ElijahSargeant/DelSlowEGT/(list of files, cad)

Other CAD files:
PCB/DelSlowEGT/ADC.dwg
PCB/DelSlowEGT/BAT.dwg
PCB/DelSlowEGT/3.3V.dwg
PCB/DelSlowEGT/MCUPinout.dwg
PCB/DelSlowEGT/ETH.dwg
