ElijahSargeant/DelSlowEGT/PCB/DelSlowEGT/DelSlowEGT.pdf

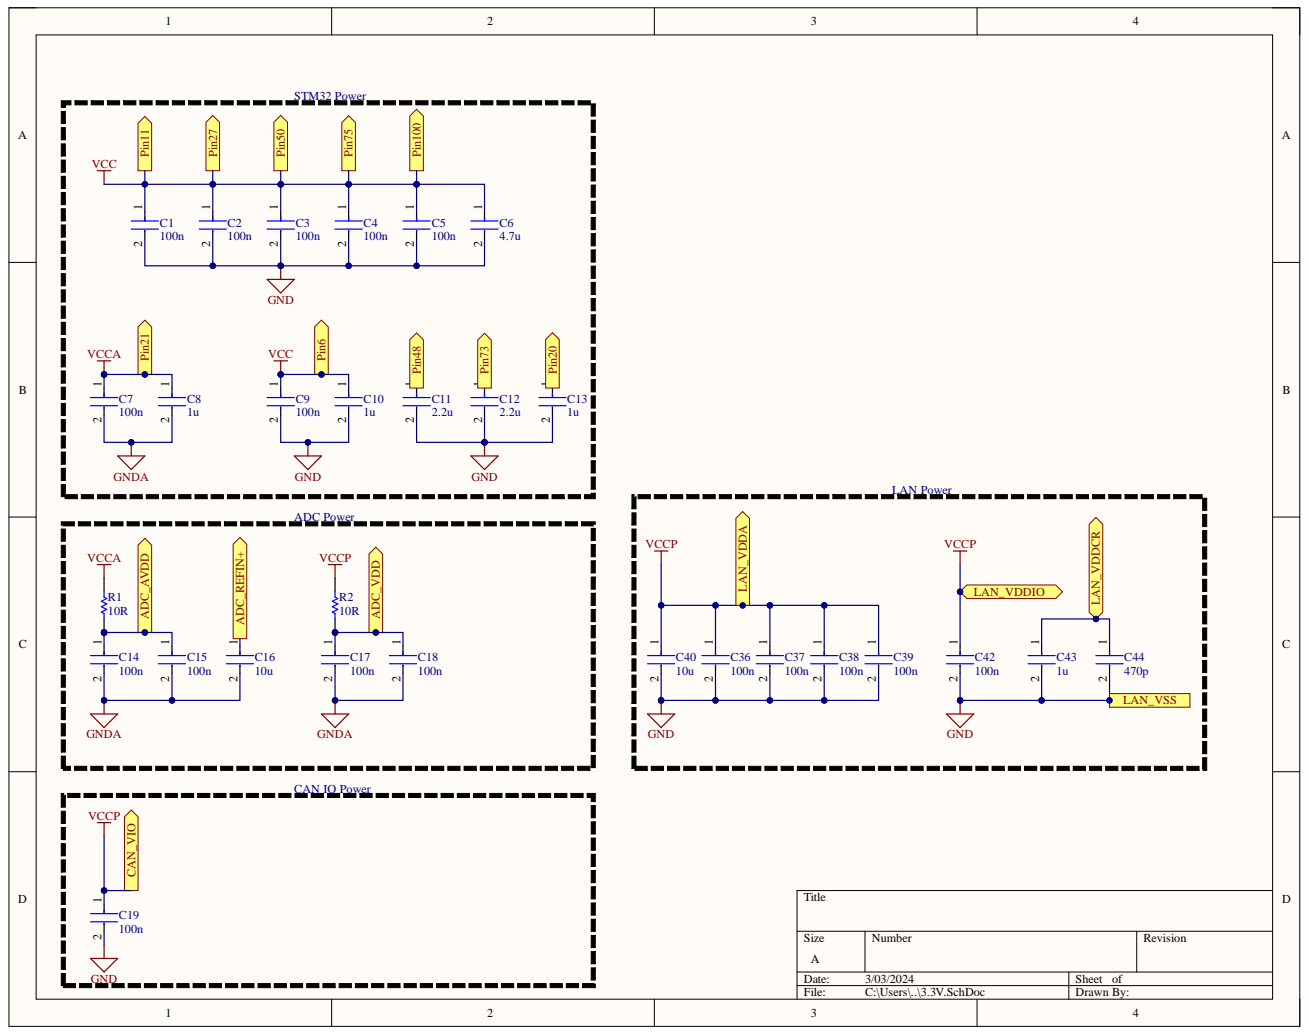
[picture p1: page 1]

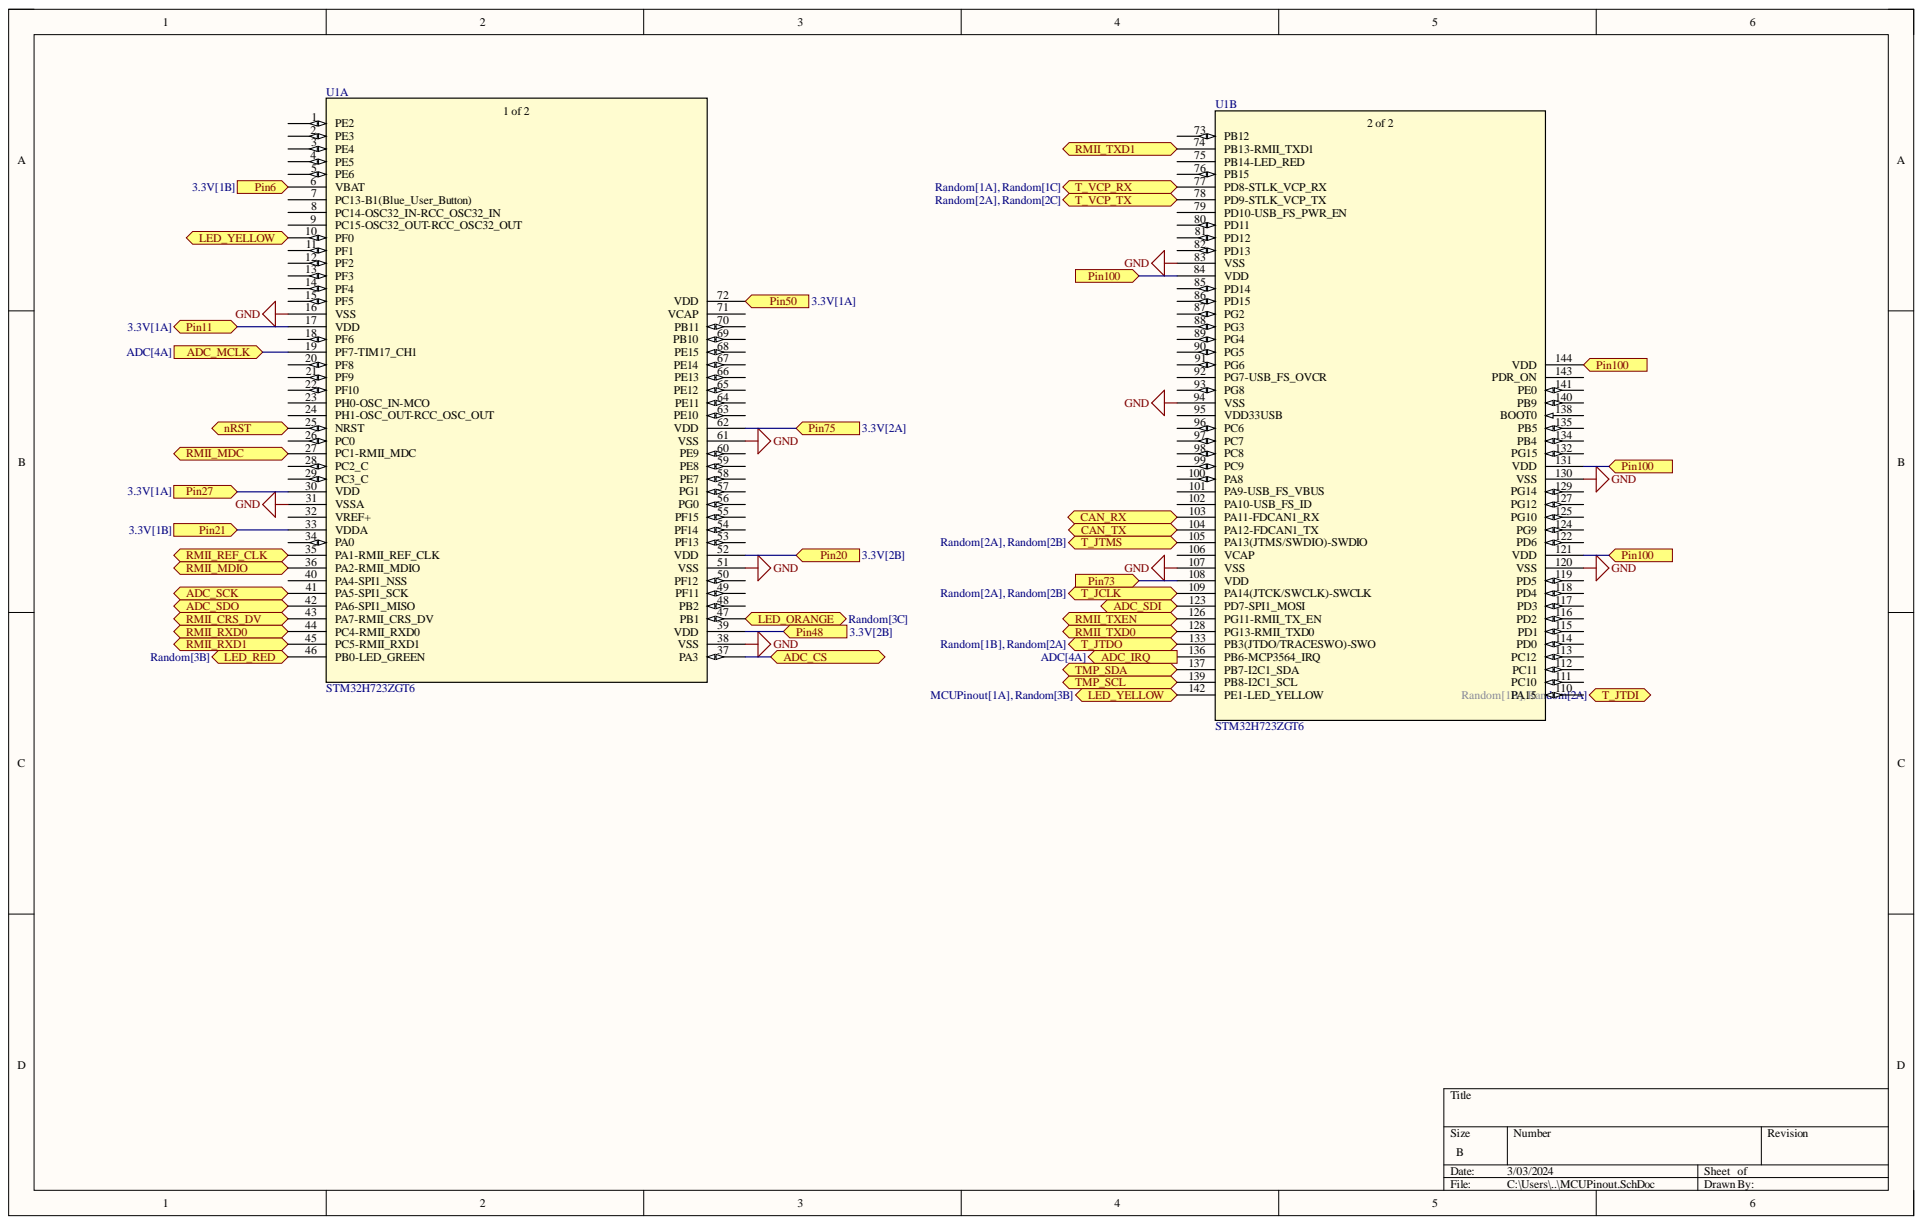
[picture p2: page 2]

Si z e | Num b er | Revi s i on

e : 3/03/ 20 24 | Sheet of
Fi l e : C : \U ser s \..\ M C UPinout.Sc hDo c | D rawn By:

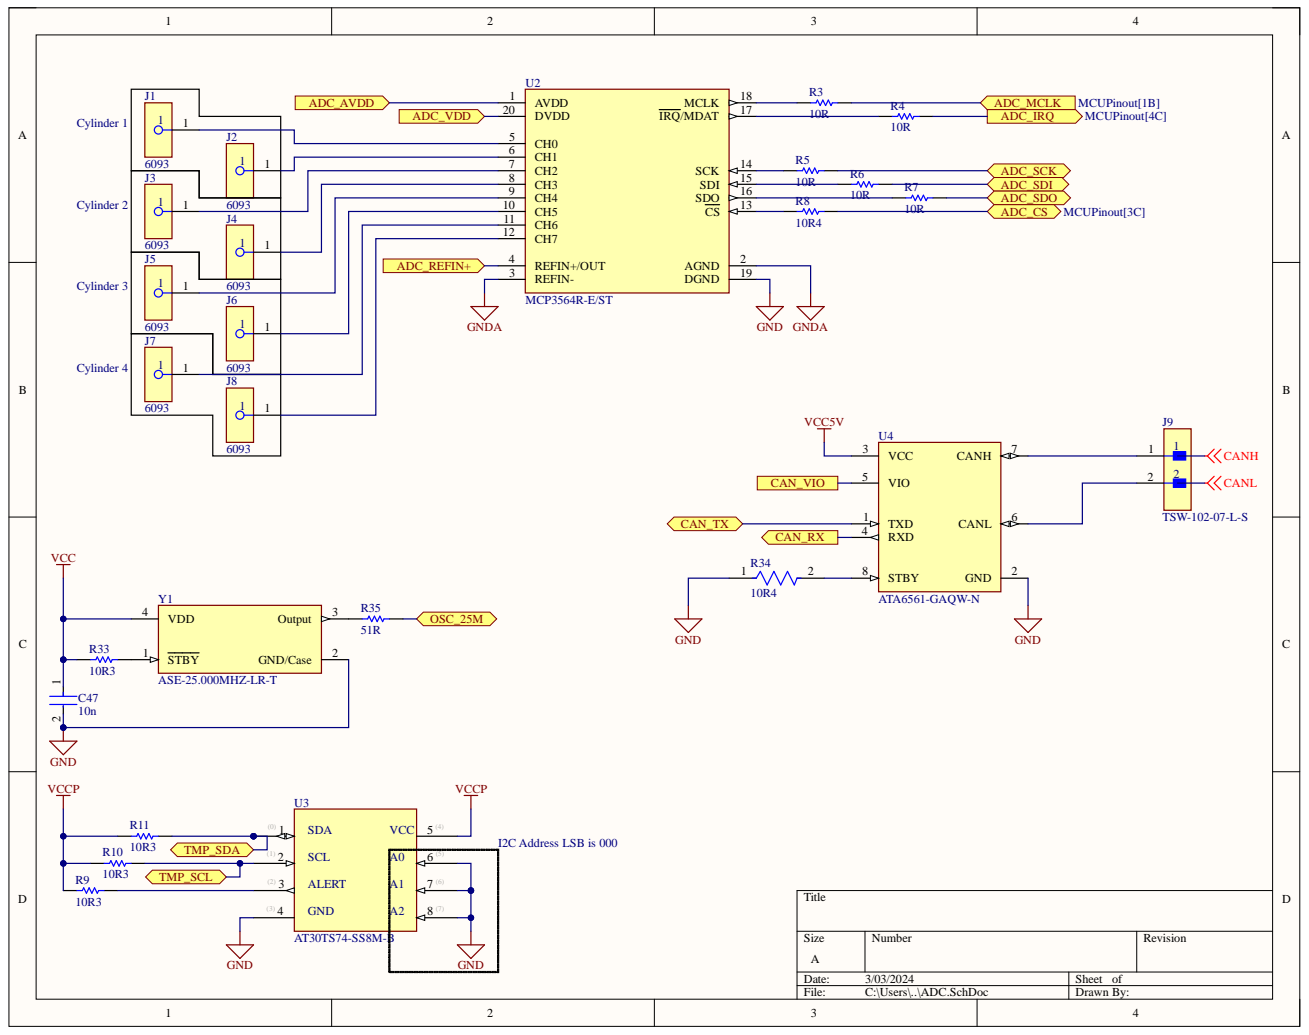
[picture p3: page 3]

J2
1 | 1 | CH1 6

6093 | | | CH5 10
J4 | | | CH6 11
1 | 1 | | | CH7 12

J5 | | | | ADC_REFIN+

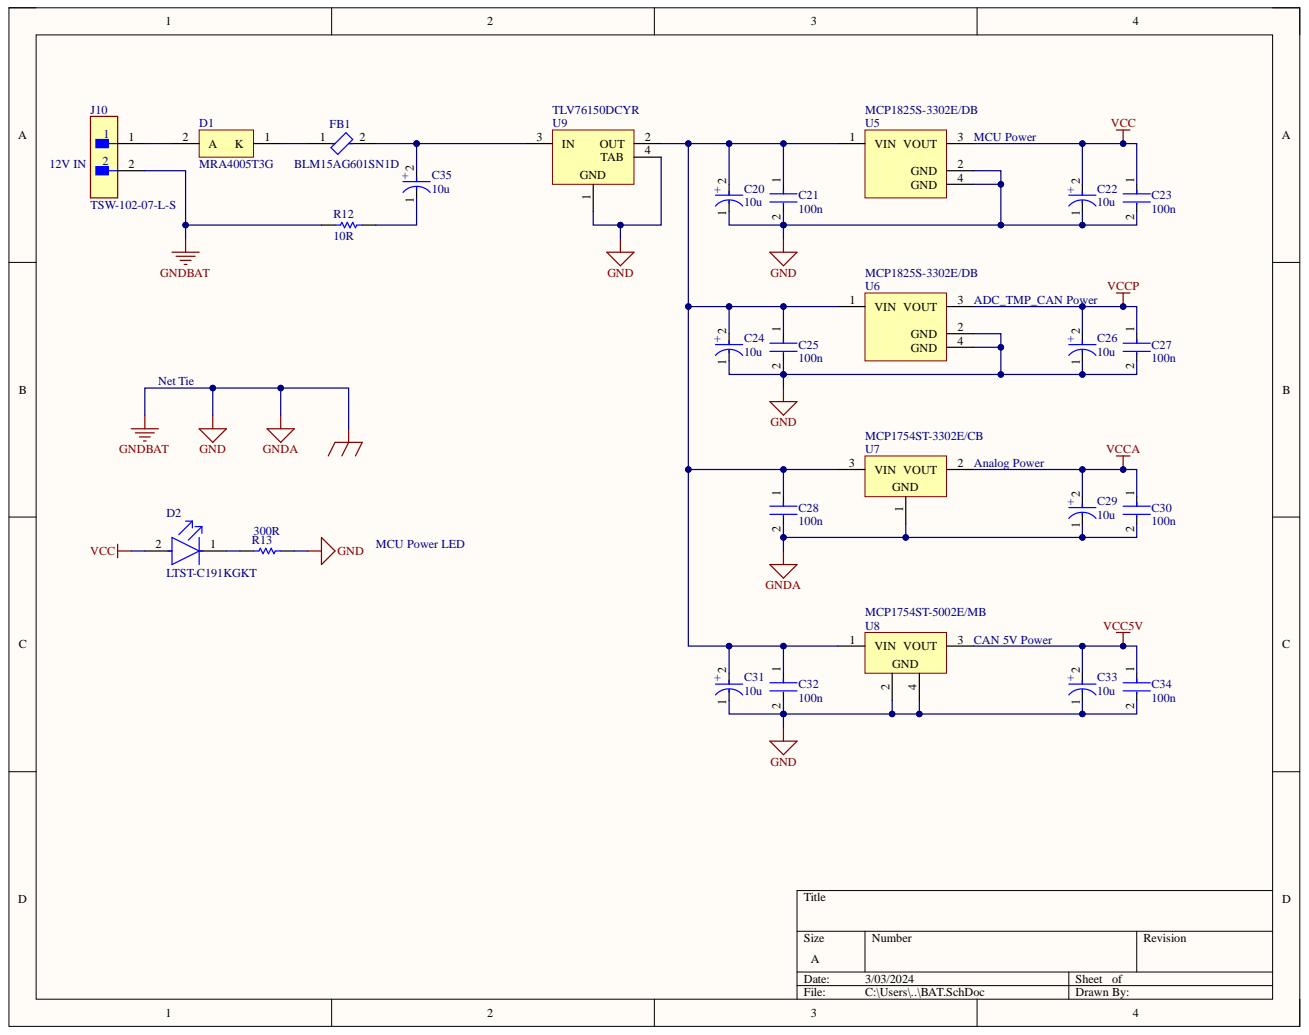
[picture p4: page 4]

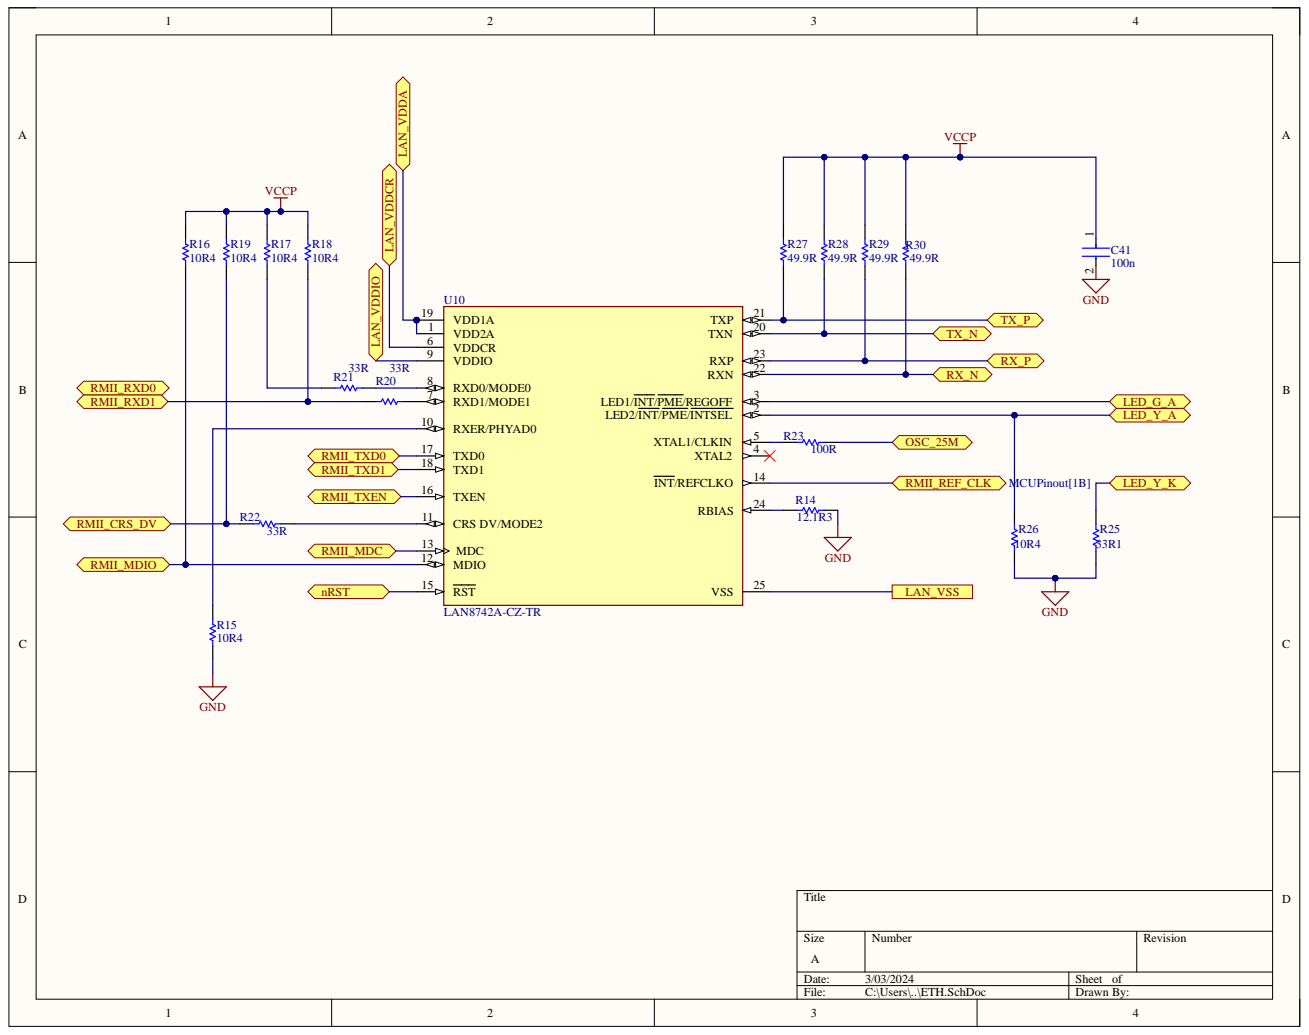
[picture p5: page 5]

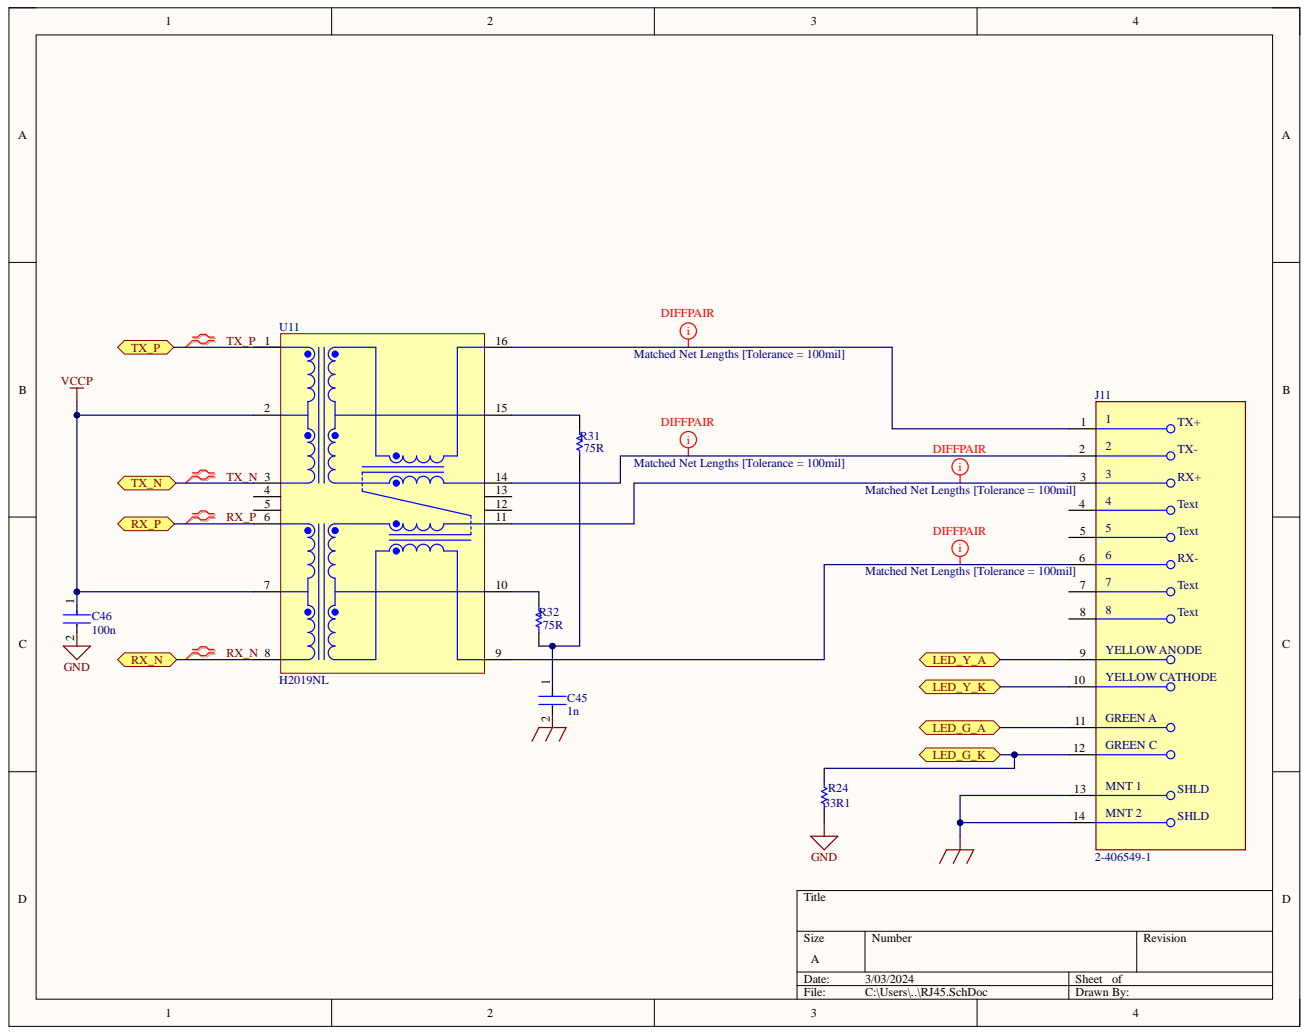
[picture p6: page 6]

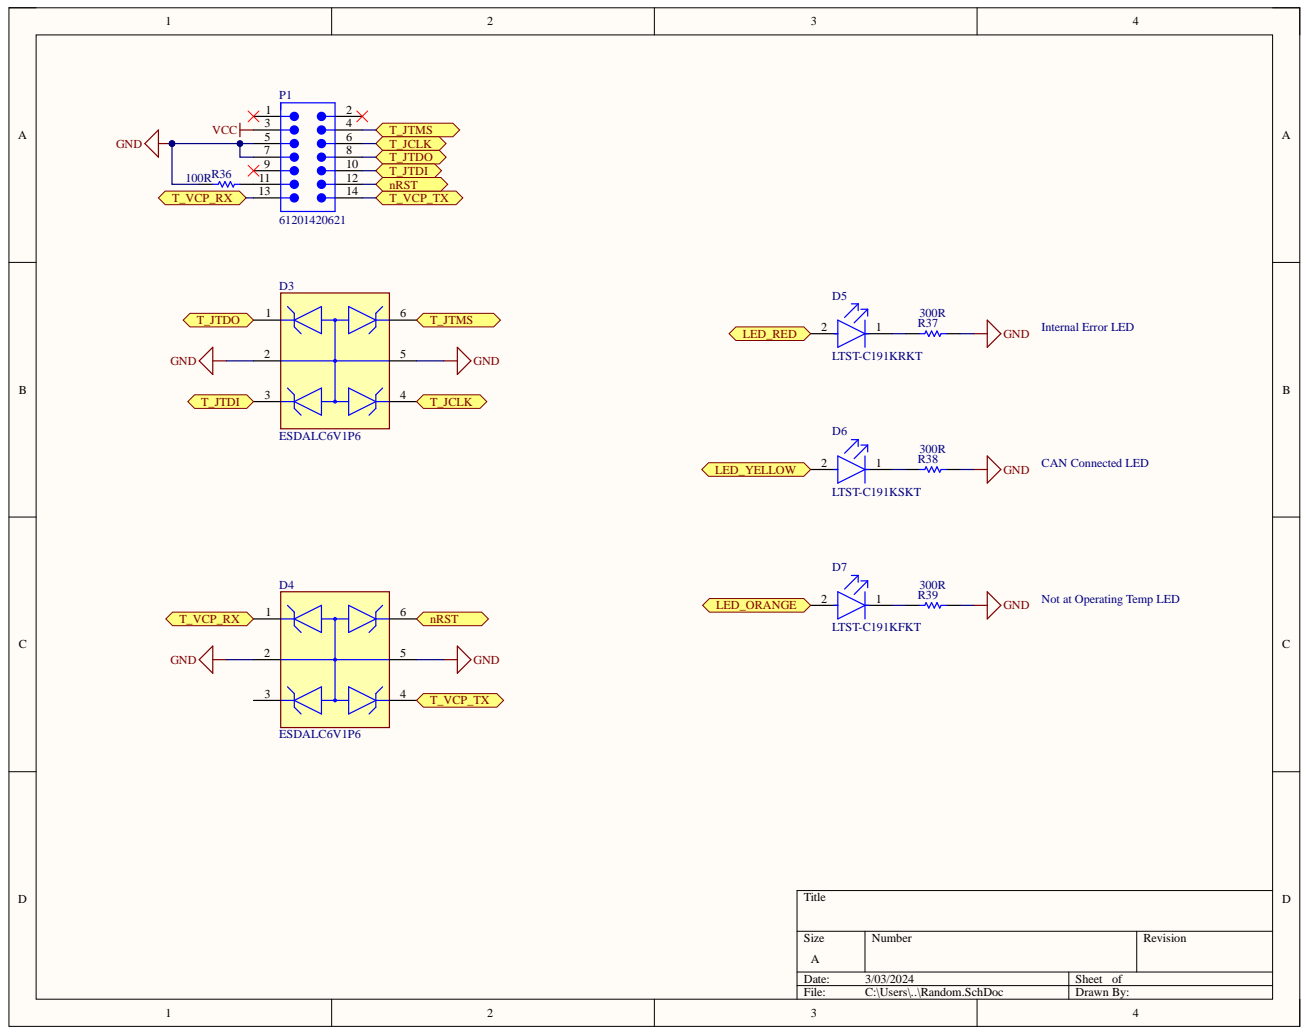
[picture p7: page 7]

GND Internal Error LED

GND CAN Connected LED

Not at Operating Temp LED LED_ORANGE

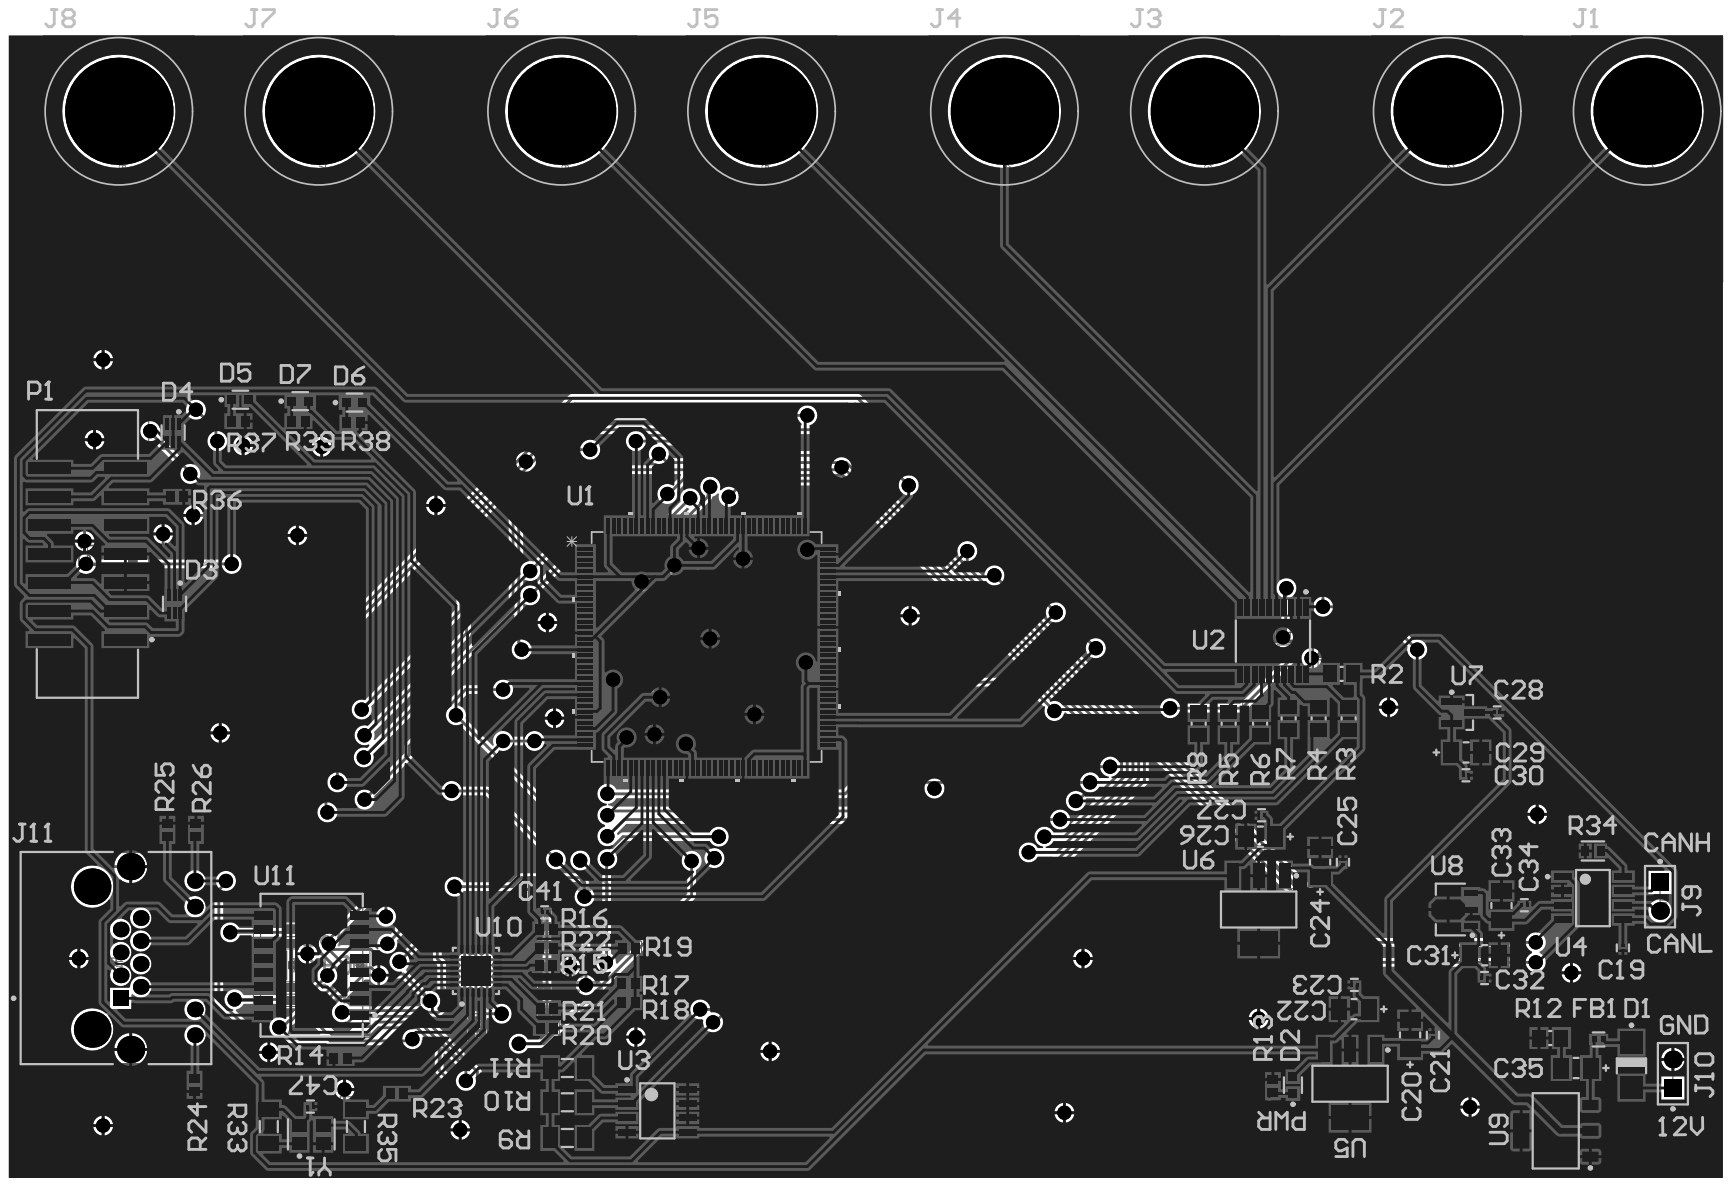
[picture p8: page 8]
