ElijahSargeant/DelSlowEGT/(list of files, drawings)

Other design files:
PCB/DelSlowEGT/3.3V.SchDoc
PCB/DelSlowEGT/ADC.SchDoc
PCB/DelSlowEGT/BAT.SchDoc
PCB/DelSlowEGT/DelSlowEGT.PrjPcb
PCB/DelSlowEGT/DelSlowEGT.SCHLIB
PCB/DelSlowEGT/ETH.SchDoc
PCB/DelSlowEGT/MCUPinout.SchDoc
PCB/DelSlowEGT/Random.SchDoc
PCB/DelSlowEGT/RJ45.SchDoc
