ElijahSargeant/DelSlowEGT/DelSlowEGT.ioc

Mcu.UserName=STM32H730VBTx
PA1.Signal=ETH_REF_CLK
PA11.Signal=FDCAN1_RX
PA12.Signal=FDCAN1_TX
PA13(JTMS/SWDIO).Signal=DEBUG_JTMS-SWDIO
PA14(JTCK/SWCLK).Signal=DEBUG_JTCK-SWCLK
PA15(JTDI).Signal=DEBUG_JTDI
PA2.Signal=ETH_MDIO
PA4.GPIO_Label=SPI1_CS
PA4.Signal=GPIO_Output
PA5.Signal=SPI1_SCK
PA6.Signal=SPI1_MISO
PA7.Signal=ETH_CRS_DV
PB11.Signal=ETH_TX_EN
PB12.Signal=ETH_TXD0
PB13.Signal=ETH_TXD1
PB3(JTDO/TRACESWO).Signal=DEBUG_JTDO-SWO
PB4(NJTRST).Signal=DEBUG_JTRST
PB6.Signal=I2C1_SCL
PB7.Signal=I2C1_SDA
PC1.Signal=ETH_MDC
PC10.Signal=UART4_TX
PC11.Signal=UART4_RX
PC4.Signal=ETH_RXD0
PC5.Signal=ETH_RXD1
PD7.Signal=SPI1_MOSI
PE4.GPIO_Label=LEDOrange
PE4.Signal=GPIO_Output
PE5.GPIO_Label=LEDRed
PE5.Signal=GPIO_Output
PE6.GPIO_Label=LEDYellow
PE6.Signal=GPIO_Output
PH0-OSC_IN.Signal=RCC_OSC_IN
