ElijahSargeant/DelSlowEGT/PCB/DelSlowEGT/Out/sizes.ini

[Page0.emf]
Pixel_PrintingWidth=5700
Pixel_PrintingHeight=4500
Mils_PrintingHeight=7500
Mils_PrintingWidth=9500
[Page1.emf]
Pixel_PrintingWidth=5700
Pixel_PrintingHeight=4500
Mils_PrintingHeight=7500
Mils_PrintingWidth=9500
[Page2.emf]
Pixel_PrintingWidth=5700
Pixel_PrintingHeight=4500
Mils_PrintingHeight=7500
Mils_PrintingWidth=9500
[Page3.emf]
Pixel_PrintingWidth=5700
Pixel_PrintingHeight=4500
Mils_PrintingHeight=7500
Mils_PrintingWidth=9500
[Page4.emf]
Pixel_PrintingWidth=5700
Pixel_PrintingHeight=4500
Mils_PrintingHeight=7500
Mils_PrintingWidth=9500
