ElijahSargeant/DelSlowEGT/(commit log)

2024-01-31 more schematic
    [3.3V.dwg, ADC.dwg, BAT.dwg, ETH.SchDoc, MCUPinout.dwg]
2024-01-31 RTOS IP Config
    [3.3V.SchDoc, ADC.SchDoc, BAT.SchDoc, DelSlowEGT.PrjPcb, ETH.SchDoc, MCUPinout.SchDoc, RJ45.SchDoc]
2024-01-31 New PDF
    [ADC.SchDoc, ETH.SchDoc, MCUPinout.SchDoc, RJ45.SchDoc]
2024-02-02 ST-Link & Step File
    [3.3V.SchDoc, BAT.SchDoc, DelSlowEGT.PrjPcb, ETH.SchDoc, MCUPinout.SchDoc, RJ45.SchDoc]
2024-02-14 Basic UDP functionality, basic ADC & Temp sensor functionality
2024-03-10 First Prototype Board
    [3.3V.SchDoc, ADC.SchDoc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]
